BazingoW/SCDTR-Distributed-Lighting-Control/custos/plot com os custos.png

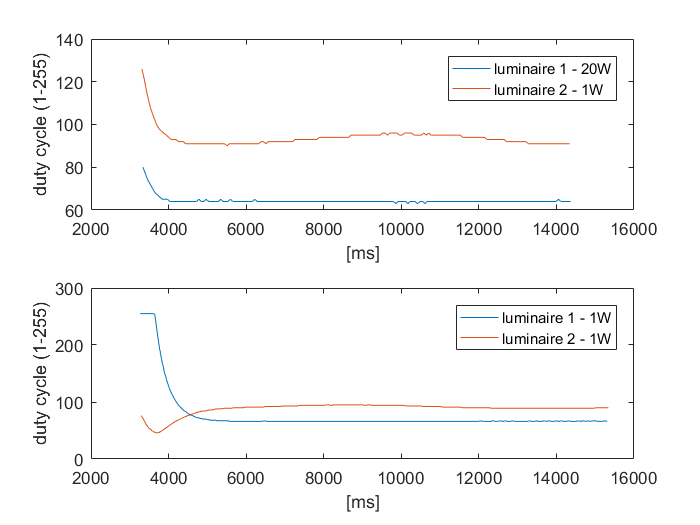
custos/plot com os custos.png
