BazingoW/SCDTR-Distributed-Lighting-Control/Imgs/avg.png

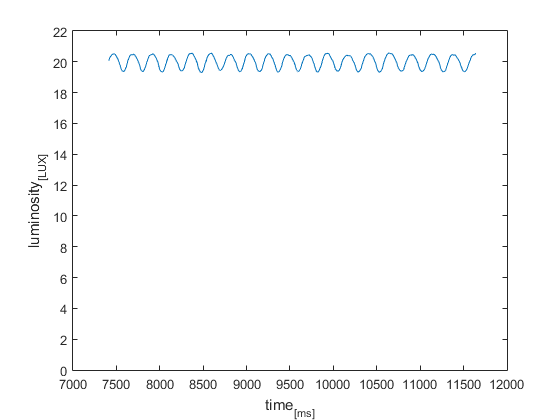
Imgs/avg.png
