BazingoW/SCDTR-Distributed-Lighting-Control/Imgs/escalaograf.png

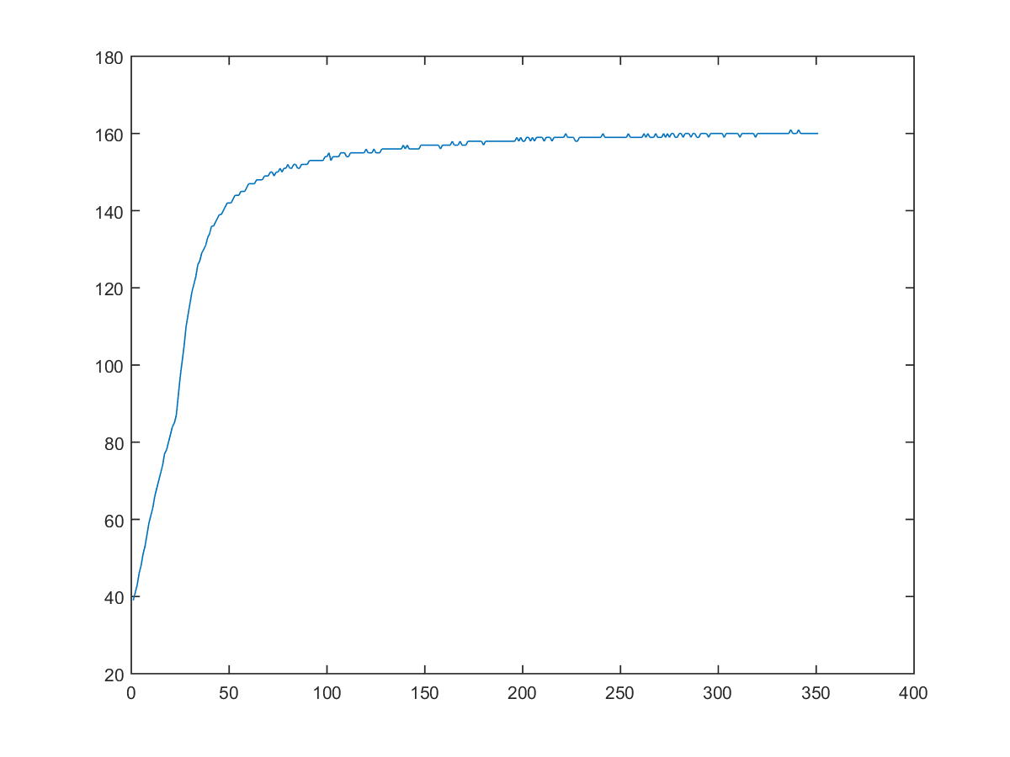
Imgs/escalaograf.png
