BazingoW/SCDTR-Distributed-Lighting-Control/Imgs/graf2.png

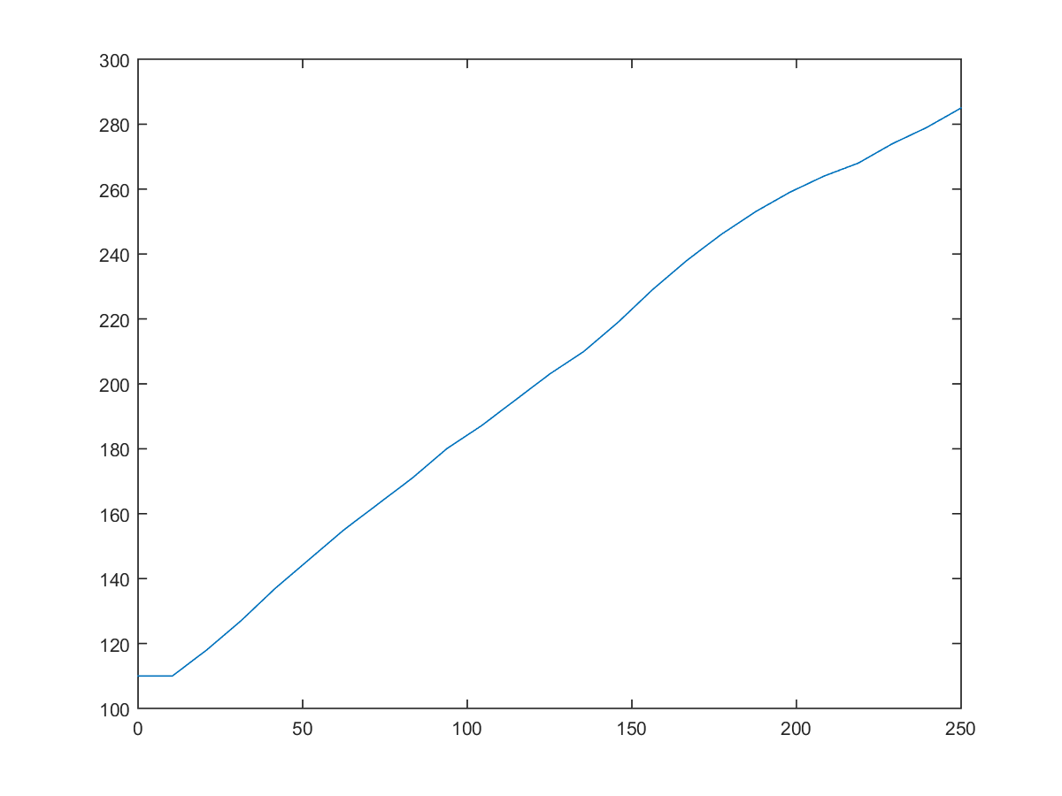
Imgs/graf2.png
