BazingoW/SCDTR-Distributed-Lighting-Control/Imgs/graficodiogo.png

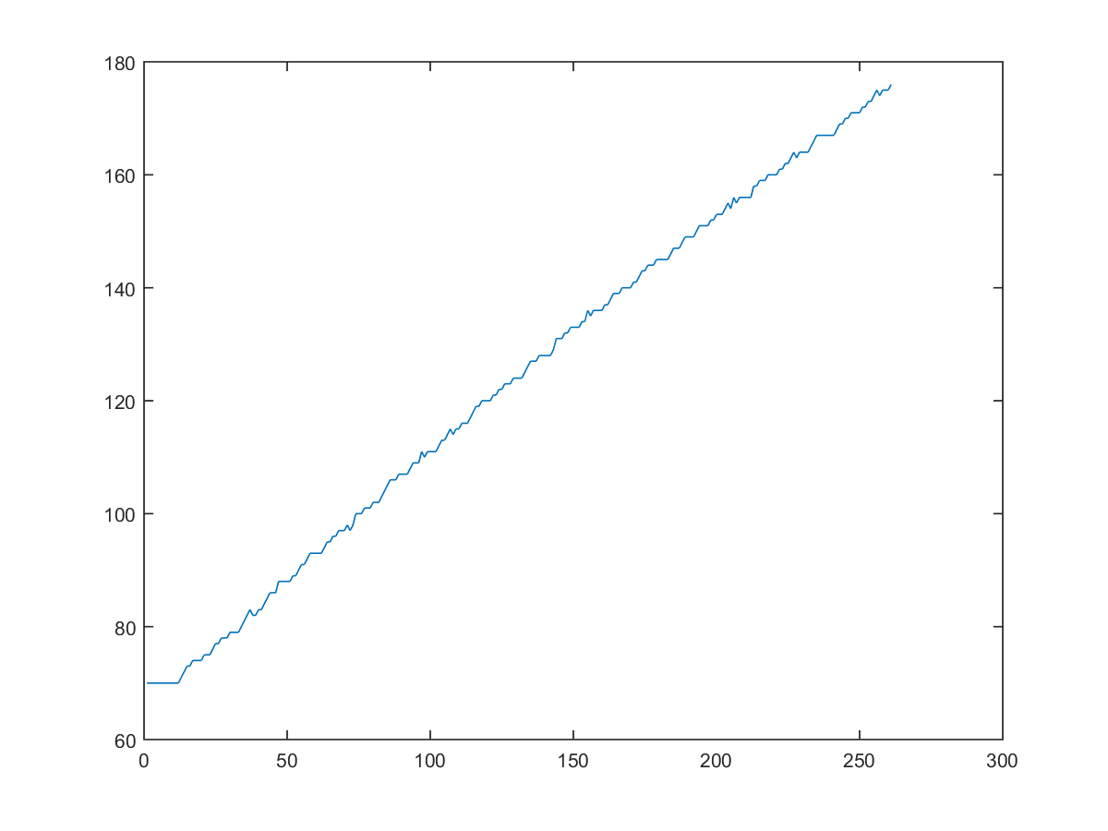
Imgs/graficodiogo.png
