BazingoW/SCDTR-Distributed-Lighting-Control/Imgs/luxscpwn.png

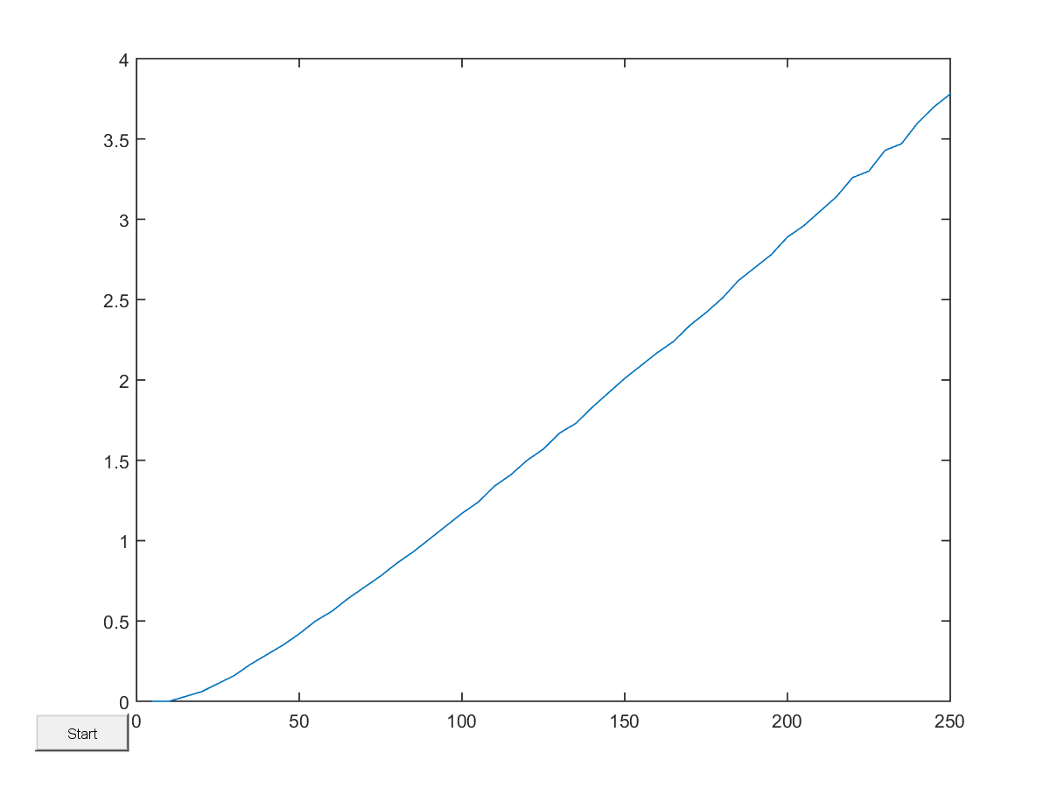
Imgs/luxscpwn.png
