BazingoW/SCDTR-Distributed-Lighting-Control/Imgs/no_avg.png

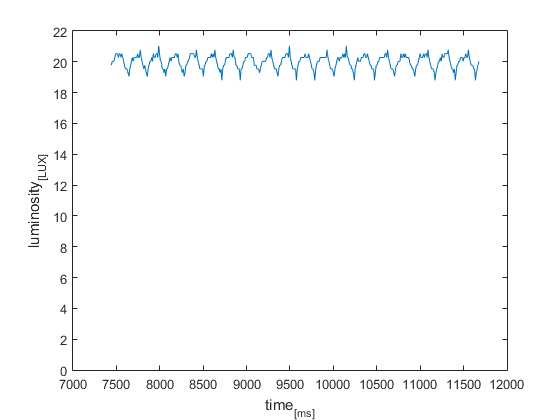
Imgs/no_avg.png
