BazingoW/SCDTR-Distributed-Lighting-Control/Imgs/pila.png

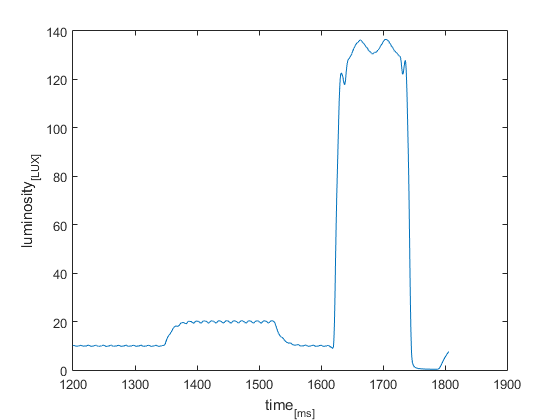
Imgs/pila.png
