BazingoW/SCDTR-Distributed-Lighting-Control/Imgs/randomshit.png

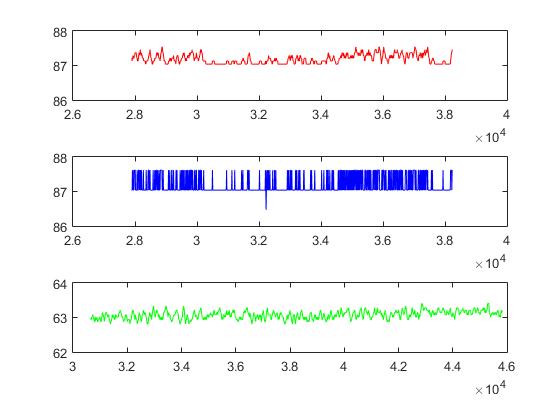
Imgs/randomshit.png
