BazingoW/SCDTR-Distributed-Lighting-Control/Imgs/transitions.png

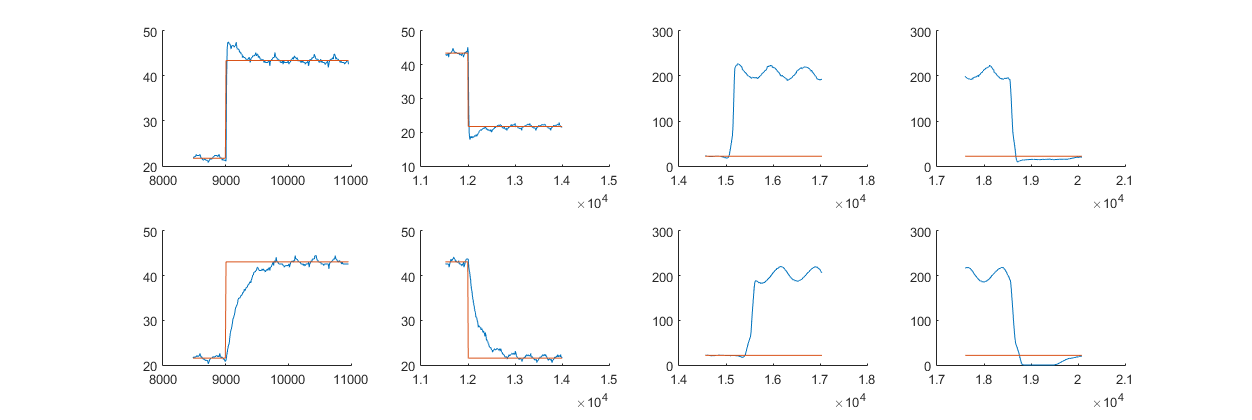
Imgs/transitions.png
