BazingoW/SCDTR-Distributed-Lighting-Control/Imgs/tudo_legendas.png

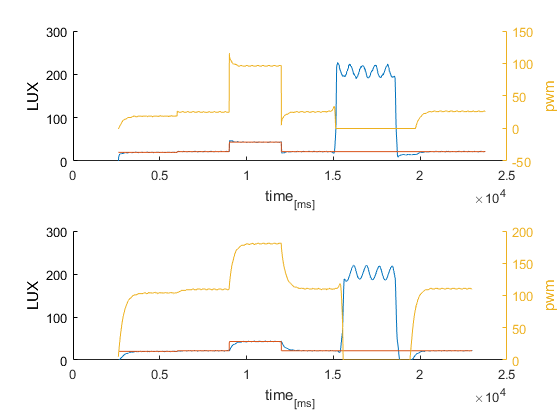
Imgs/tudo_legendas.png
