BazingoW/SCDTR-Distributed-Lighting-Control/calibracao/acoplado/lums3.csv

78.7 | 5.68799e+06
79.67 | 5.688e+06
79.67 | 5.688e+06
79.67 | 5.68803e+06
79.67 | 5.68806e+06
79.67 | 5.68809e+06
79.67 | 5.68811e+06
79.67 | 5.68814e+06
79.67 | 5.68817e+06
79.67 | 5.6882e+06
79.67 | 5.68822e+06
79.67 | 5.68825e+06
79.67 | 5.68828e+06
79.67 | 5.68831e+06
79.67 | 5.68834e+06
79.67 | 5.68837e+06
79.67 | 5.68839e+06
79.67 | 5.68842e+06
79.67 | 5.68845e+06
79.67 | 5.68848e+06
79.67 | 5.6885e+06
79.67 | 5.68853e+06
79.67 | 5.68856e+06
79.67 | 5.68859e+06
79.67 | 5.68862e+06
79.67 | 5.68864e+06
79.67 | 5.68867e+06
79.67 | 5.6887e+06
79.67 | 5.68873e+06
79.67 | 5.68876e+06
79.67 | 5.68878e+06
79.67 | 5.68881e+06
79.67 | 5.68884e+06
79.67 | 5.68887e+06
79.67 | 5.6889e+06
79.67 | 5.68893e+06
79.67 | 5.68895e+06
79.67 | 5.68898e+06
79.67 | 5.68901e+06
79.67 | 5.68904e+06
79.67 | 5.68906e+06
79.67 | 5.68909e+06
79.67 | 5.68912e+06
79.67 | 5.68915e+06
79.67 | 5.68918e+06
79.67 | 5.6892e+06
79.67 | 5.68923e+06
79.67 | 5.68926e+06
79.67 | 5.68929e+06
79.67 | 5.68932e+06
79.67 | 5.68934e+06
79.67 | 5.68937e+06
79.67 | 5.6894e+06
79.67 | 5.68943e+06
79.67 | 5.68946e+06
79.67 | 5.68948e+06
79.67 | 5.68951e+06
79.67 | 5.68954e+06
79.67 | 5.68957e+06
10.81 | 3268.85
32.1 | 3331.56
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
