BazingoW/SCDTR-Distributed-Lighting-Control/calibracao/acoplado/lums4.csv

70.62 | 5.68799e+06
87.78 | 3209.69
74.96 | 3329.72
74.96 | 3393.35
74.47 | 3455.87
74.47 | 3518.45
62.47 | 3581.32
51.6 | 3644.07
44.48 | 3706.86
40.72 | 3769.61
36.22 | 3832.3
32.3 | 3894.88
30.86 | 3957.59
30.58 | 4020.25
27.28 | 4082.98
25.96 | 4145.78
26.75 | 4208.53
25.19 | 4271.42
24.18 | 4334.27
24.68 | 4395.96
24.43 | 4458.85
22.46 | 4521.8
23.43 | 4584.65
24.18 | 4646.67
22.46 | 4709.73
22.7 | 4772.81
23.19 | 4834.58
22.46 | 4897.53
22.21 | 4960.48
22.94 | 5023.44
22.46 | 5085.33
22.21 | 5148.38
22.46 | 5211.52
22.7 | 5273.43
21.74 | 5336.56
21.97 | 5399.55
22.46 | 5461.51
22.21 | 5524.73
21.5 | 5586.93
21.97 | 5649.9
22.46 | 5713.05
21.5 | 5775.04
22.21 | 5838.23
22.46 | 5900.35
22.21 | 5963.72
21.26 | 6025.83
21.97 | 6089.22
22.21 | 6151.69
21.74 | 6215.05
21.74 | 6277.14
22.21 | 6340.49
22.21 | 6402.59
21.5 | 6465.85
21.97 | 6528.15
22.46 | 6590.55
21.74 | 6653.55
21.97 | 6716.02
22.21 | 6778.26
22.46 | 6841.45
21.26 | 6903.78
22.21 | 6966.9
22.46 | 7029.26
21.74 | 7092.4
21.5 | 7154.84
22.21 | 7217.95
22.21 | 7280.4
21.5 | 7343.42
21.74 | 7405.93
22.46 | 7468.21
22.21 | 7531.43
21.5 | 7593.74
22.21 | 7656.99
22.46 | 7719.41
21.5 | 7781.71
21.74 | 7844.92
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
