BazingoW/SCDTR-Distributed-Lighting-Control/calibracao/desacoplado/lums4.csv

114.29 | 6.26042e+06
41.39 | 3293.68
46.98 | 3355.78
44.83 | 3418.87
41.73 | 3481.31
40.39 | 3543.74
39.73 | 3606.13
38.11 | 3668.83
37.79 | 3731.6
38.11 | 3794.25
37.16 | 3857.03
36.53 | 3919.88
33.78 | 3982.68
31.43 | 4045.45
28.36 | 4108.11
28.9 | 4170.94
27.55 | 4233.99
27.28 | 4297.08
26.75 | 4358.96
25.96 | 4422.23
26.22 | 4485.29
26.75 | 4548.31
26.75 | 4610.4
26.75 | 4673.5
26.22 | 4736.51
26.75 | 4799.55
27.55 | 4862.59
27.55 | 4925.16
27.82 | 4988.22
26.49 | 5050.67
27.1 | 5113.91
27.82 | 5177.12
28.9 | 5239.21
28.36 | 5302.3
27.28 | 5365.37
26.75 | 5428.46
27.28 | 5491.48
27.82 | 5554.66
28.36 | 5617.87
28.63 | 5681.05
28.36 | 5744.14
28.36 | 5806.36
27.28 | 5869.48
27.1 | 5932.79
26.75 | 5996.04
27.82 | 6059.28
28.36 | 6122.52
28.63 | 6184.81
28.63 | 6247.99
28.9 | 6311.45
27.55 | 6373.81
27.1 | 6437.12
26.49 | 6500.32
27.28 | 6563.76
28.36 | 6625.94
28.63 | 6689.4
28.9 | 6752.75
28.36 | 6815.58
27.55 | 6878.19
27.1 | 6940.88
27.1 | 7004.29
27.28 | 7067.52
28.9 | 7130.21
28.63 | 7193.56
28.9 | 7256.08
28.36 | 7319.44
27.82 | 7382.08
27.1 | 7445.5
26.75 | 7508.09
27.28 | 7571.49
27.55 | 7634.75
28.36 | 7697.52
28.9 | 7760.66
28.9 | 7823.14
28.36 | 7886.43
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
