BazingoW/SCDTR-Distributed-Lighting-Control/Server/i2cV1.cpp

#include <unistd.h>				//Needed for I2C port
#include <fcntl.h>				//Needed for I2C port
#include <sys/ioctl.h>			//Needed for I2C port
#include <linux/i2c-dev.h>		//Needed for I2C port
#include <iostream>

int main(int argc, char const *argv[]) {
  int file_i2c;
  int length;
  unsigned char buffer[60] = {0};


  //----- OPEN THE I2C BUS -----
  char *filename = (char*)"/dev/i2c-1";


  if ((file_i2c = open(filename, O_RDWR)) < 0)
  {
    //ERROR HANDLING: you can check errno to see what went wrong
    std::cout << "Failed to open the i2c bus" << '\n';

    return 0;
  }

  int addr = 0x08;          //<<<<<The I2C address of the slave
  if (ioctl(file_i2c, I2C_SLAVE, addr) < 0)
  {
      std::cout << "Failed to acquire bus access and/or talk to slave." << '\n';

    //ERROR HANDLING; you can check errno to see what went wrong
    return 0;
  }


  //----- READ BYTES -----
  length = 4;			//<<< Number of bytes to read
  if (read(file_i2c, buffer, length) != length)		//read() returns the number of bytes actually read, if it doesn't match then an error occurred (e.g. no response from the device)
  {
    //ERROR HANDLING: i2c transaction failed
          std::cout << "Failed to read from the i2c bus." << '\n';

  }
  else
  {
      std::cout << "Data read:" << buffer<< '\n';

  }


  //----- WRITE BYTES -----
  buffer[0] = 0x01;
  buffer[1] = 0x02;
  length = 2;			//<<< Number of bytes to write
  if (write(file_i2c, buffer, length) != length)		//write() returns the number of bytes actually written, if it doesn't match then an error occurred (e.g. no response from the device)
  {
    /* ERROR HANDLING: i2c transaction failed */
        std::cout << "Failed to write to the i2c bus.\n";

  }
  return 0;
}
