BazingoW/SCDTR-Distributed-Lighting-Control/(commit log)

2017-10-25 o ramiro diz que chega
2017-10-27 windup bom-entrega final part 1
2017-10-28 a meio do processo de commentar\n codigo simplificado e comentado \n vetor agora chama-se lookUp \n ja nao da warning de memoria
2017-10-28 codigo mais simplificado e melhorado o u agora e' o usat e viceversa descobri bug manhoso que o feedforward estava a alterar referencia pq havi la uma linha que fazia isso codigo comentado
    [Codigo.ino]
2017-11-17 Definir os endereços dos arduinos
2017-12-05 erro de sintaxes e essas coisas ja não aparecem
2017-12-07 consensus funcional ver mais comunicações i2c
2017-12-08 commit para estar tudo actualizado antes de irmos trabalhar
2017-12-10 last minute print kinda done
2017-12-10 algumas transmições entre arduinos
2017-12-11 mensagens entre arduinos mais completas
2017-12-11 para nao ficar sem bateria
2017-12-12 manda sempre os valroes de luxs e duty_cicle
2017-12-14 comms dos arduinos funcional, estado apresenta valor estranhos
2017-12-15 miragaia nao sabe o que tem de resolver
    [sketch_dec12a.ino]
2017-12-17 codigo arduinos
